lhr-solar/VehicleControlUnit/README.md

# VehicleControlUnit
Vehicle Control Unit (VCU) for the 2027 Longhorn Racing Solar car
