lhr-solar/VehicleControlUnit/Hardware/VehicleControlUnit/3d models/ROE-3.305S.step

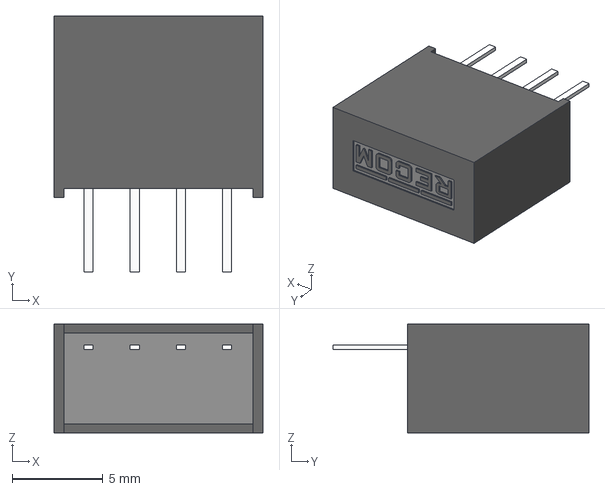
[picture p1: CAD file, 2026-09-12]
Hardware/VehicleControlUnit/3d models/ROE-3.305S.step
11.5 x 14.1 x 6.00 mm
