lhr-solar/VehicleControlUnit/Hardware/VehicleControlUnit/3d models/IRLML2030TRPBF.stp

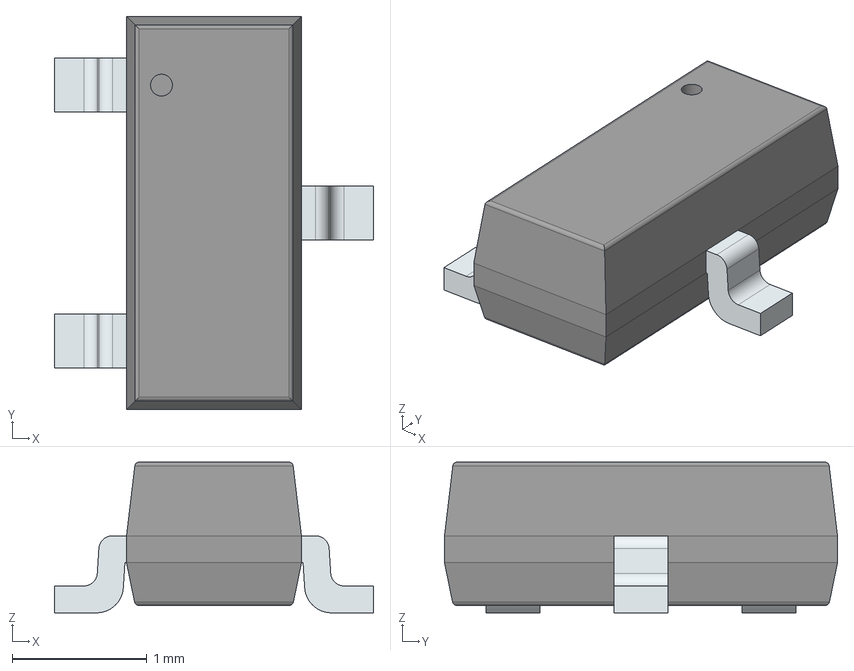
[picture p2: CAD file, 2026-09-12]
Hardware/VehicleControlUnit/3d models/IRLML2030TRPBF.stp
2.37 x 2.92 x 1.12 mm
PinsArrayL
FilletPinR
