lhr-solar/VehicleControlUnit/Hardware/VehicleControlUnit/3d models/VSSAF522-M3_H.stp

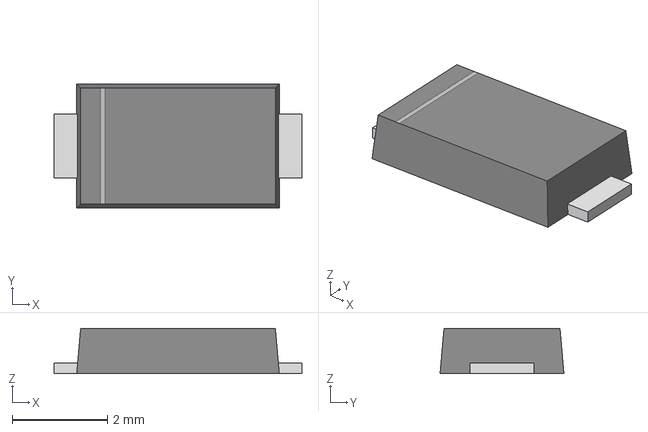
[picture p3: CAD file, 2026-09-12]
Hardware/VehicleControlUnit/3d models/VSSAF522-M3_H.stp
5.20 x 2.60 x 0.951 mm
