lhr-solar/VehicleControlUnit/Hardware/VehicleControlUnit/3d models/EMC2305-1-AP-TR.stp

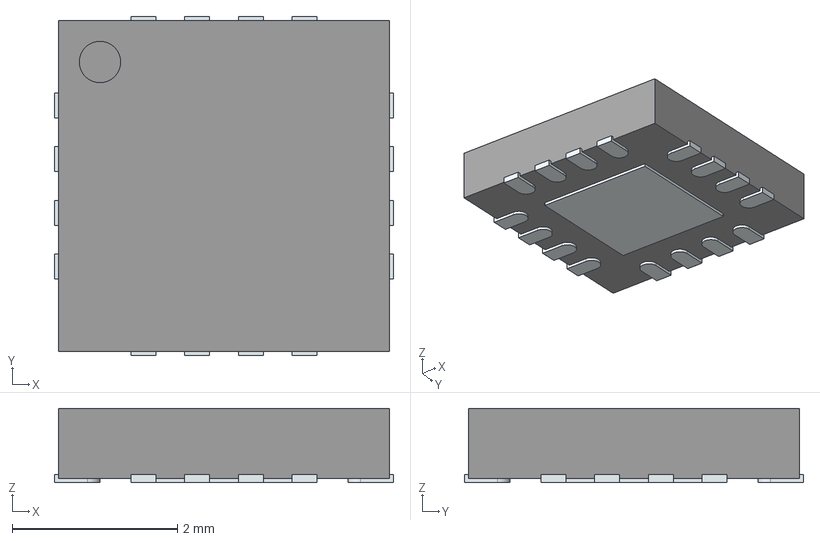
[picture p4: CAD file, 2026-09-07]
Hardware/VehicleControlUnit/3d models/EMC2305-1-AP-TR.stp
4.10 x 4.10 x 0.9 mm
ThermalPin
PinsArrayLR
PinsArrayTB
