lhr-solar/VehicleControlUnit/Hardware/VehicleControlUnit/3d models/MCP4822T-E_SN.stp

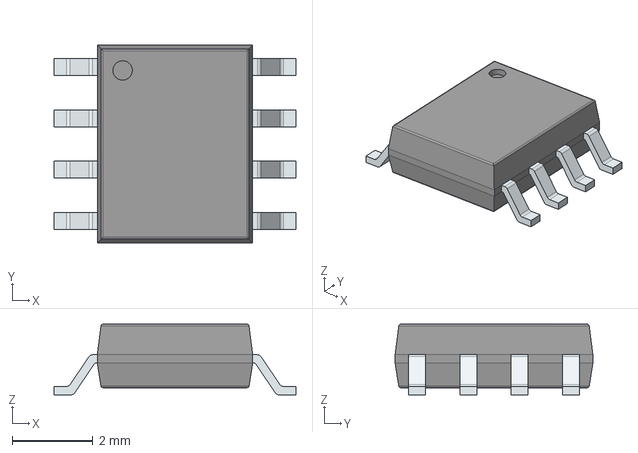
[picture p5: CAD file, 2026-09-07]
Hardware/VehicleControlUnit/3d models/MCP4822T-E_SN.stp
6.00 x 4.90 x 1.75 mm
PinsArrayLR
