lhr-solar/VehicleControlUnit/Hardware/VehicleControlUnit/3d models/ISO7741DWR.stp

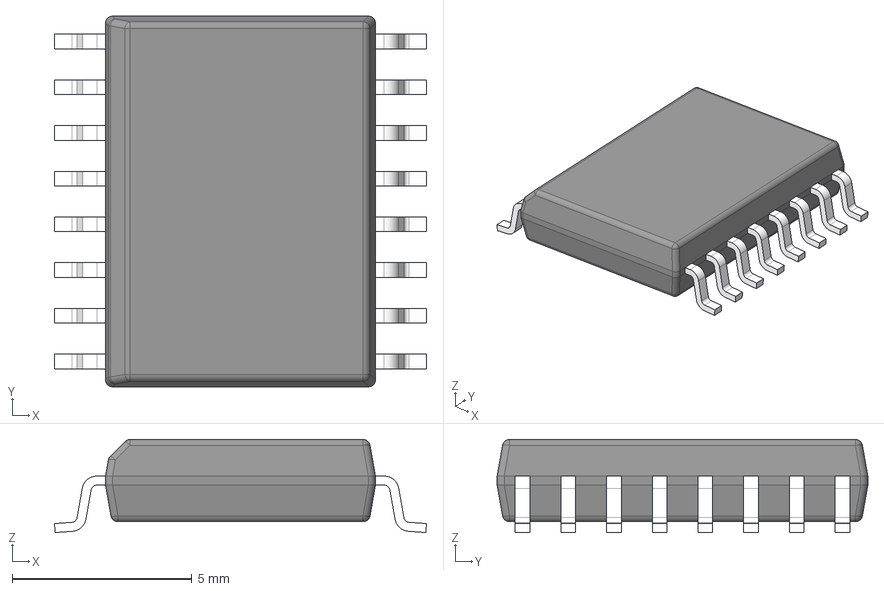
[picture p6: CAD file, 2026-09-07]
Hardware/VehicleControlUnit/3d models/ISO7741DWR.stp
10.3 x 10.3 x 2.59 mm
BODY-SOIC
LEAD-DW0016 x 16
