lhr-solar/VehicleControlUnit/Hardware/VehicleControlUnit/12VBuck.kicad_sch

## KiCad design Hardware/VehicleControlUnit/12VBuck.kicad_sch (2026-09-12)

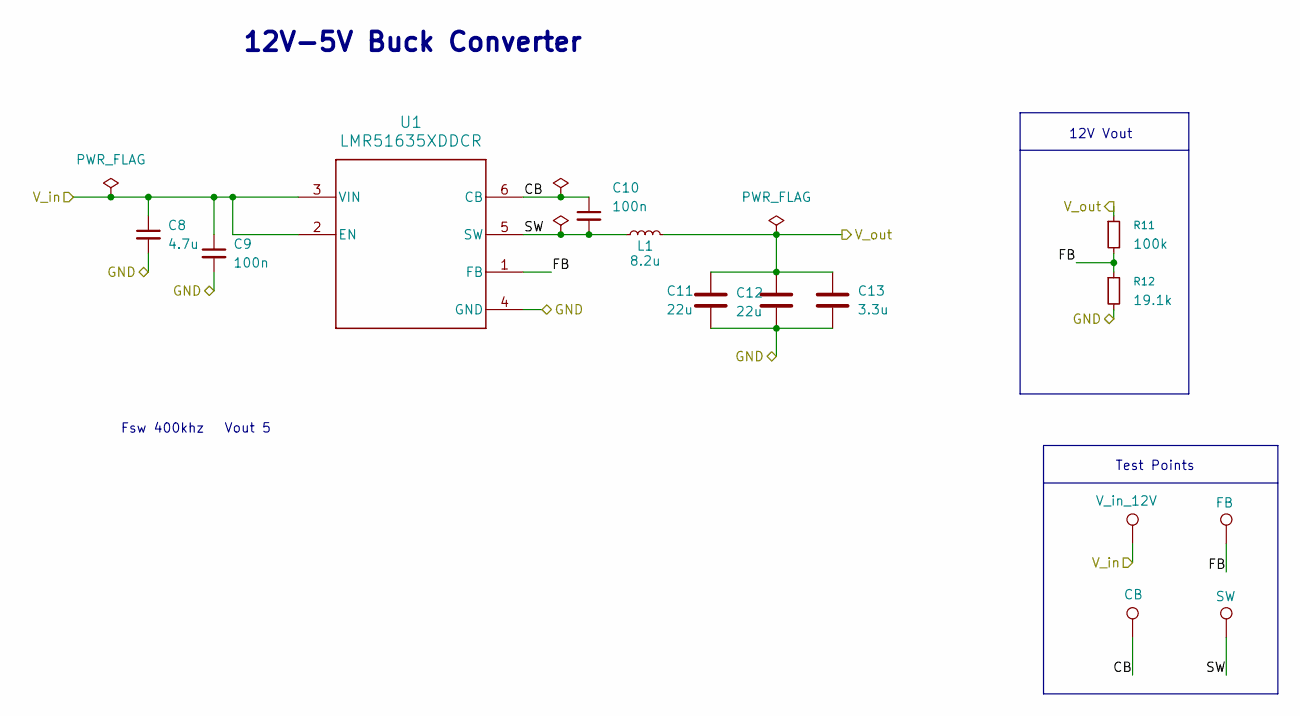
[picture p7: schematic 12VBuck.kicad_sch]

Parts:
C8: 4.7u; C_0805_2012Metric_Pad1.18x1.45mm_HandSolder; LCSC P/N C6962403
C9: 100n; C_0603_1608Metric_Pad1.08x0.95mm_HandSolder; LCSC P/N C6666325
C10: 100n; C_0603_1608Metric; LCSC P/N C6666325
C11, C12: 22u; C_1210_3225Metric_Pad1.33x2.70mm_HandSolder; LCSC P/N C778721
C13: 3.3u; C_0805_2012Metric_Pad1.18x1.45mm_HandSolder; LCSC P/N C342775
L1: 8.2u; 74439369082
R11: 100k; R_0603_1608Metric; LCSC P/N C25803
R12: 19.1k; R_0603_1608Metric; LCSC P/N C844132
TP1: V_in_12V; TestPoint_THTPad_D3.0mm_Drill1.5mm
TP2: CB; TestPoint_THTPad_D3.0mm_Drill1.5mm
TP3: FB; TestPoint_THTPad_D3.0mm_Drill1.5mm
TP4: SW; TestPoint_THTPad_D3.0mm_Drill1.5mm
U1: LMR51635XDDCR; DDC0006A-MFG; LCSC P/N C42432812

Connections:
CB: C10.1, TP2.1, U1.6 (CB)
FB: R11.2, R12.1, TP3.1, U1.1 (FB)
GND: C8.2, C9.2, C11.2, C12.2, C13.2, R12.2, U1.4 (GND)
SW: C10.2, L1.1, TP4.1, U1.5 (SW)
V_in: C8.1, C9.1, TP1.1, U1.2 (EN), U1.3 (VIN)
V_out: C11.1, C12.1, C13.1, L1.2, R11.1

Notes on the sheet:
12V Vout
Test Points
Fsw 400khz
Vout 5
12V-5V Buck Converter
