lhr-solar/VehicleControlUnit/Hardware/VehicleControlUnit/100PinMCU.kicad_sch

## KiCad design Hardware/VehicleControlUnit/100PinMCU.kicad_sch (2026-09-12)

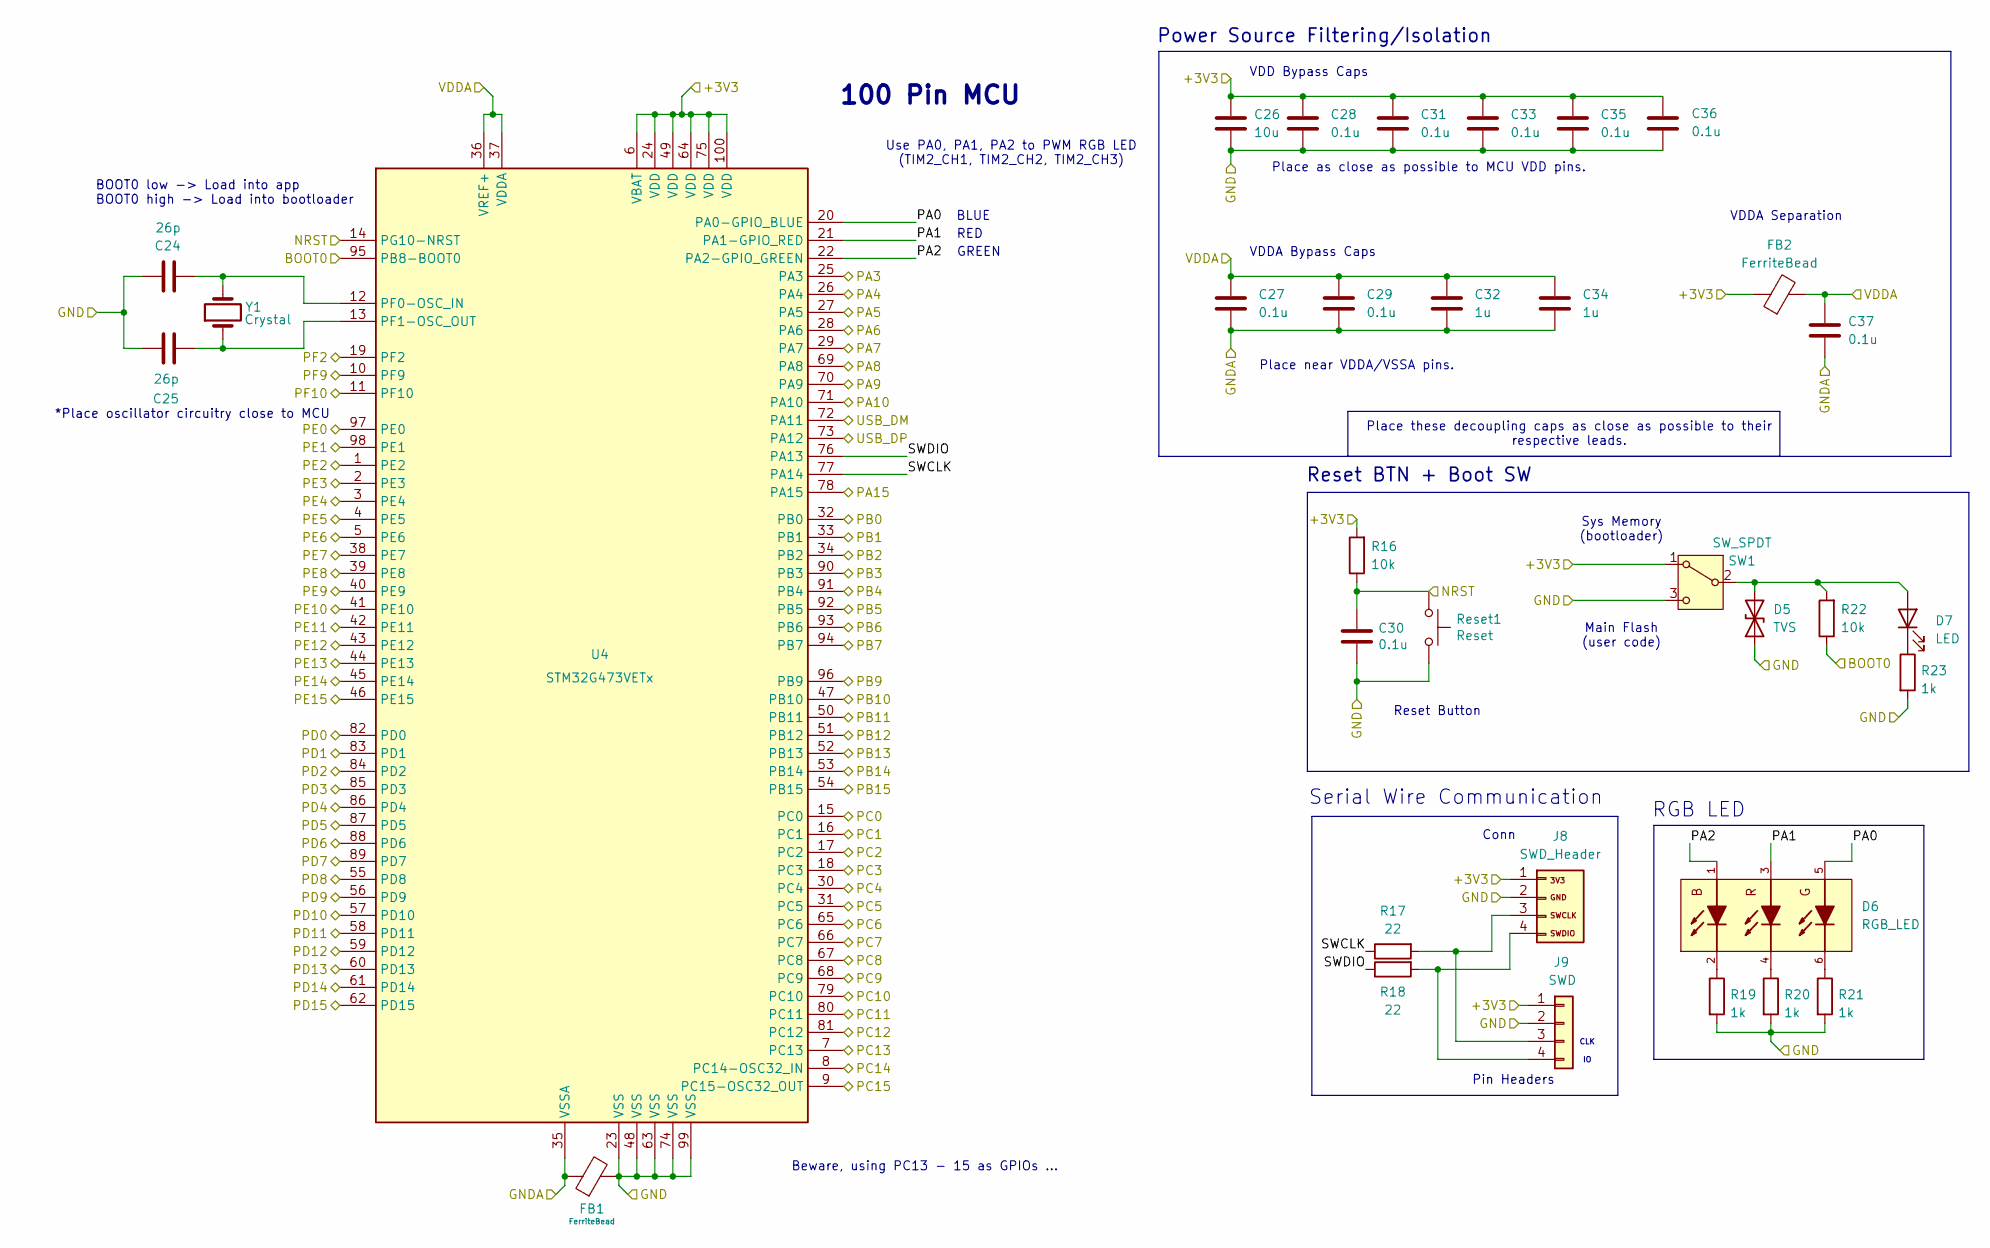
[picture p8: schematic 100PinMCU.kicad_sch]

Parts:
C24, C25: 26p; C_0603_1608Metric_Pad1.08x0.95mm_HandSolder; LCSC P/N C92670
C26: 10u; C_0805_2012Metric; Mouser Part Number 08055D475KAT4A
C27, C28, C29, C30, C31, C33, C35, C36, C37: 0.1u; C_0603_1608Metric_Pad1.08x0.95mm_HandSolder; Mouser Part Number MLASH168SB7104KTNA01
C32, C34: 1u; C_0603_1608Metric_Pad1.08x0.95mm_HandSolder; Mouser Part Number MLASH168SB7104KTNA01
D5: TVS; D_SOD-323; Mouser P/N 771-PESD15VL1BA-T/R
D6: RGB_LED; LCSC P/N C264519
D7: LED; LED_0603_1608Metric; LCSC P/N C125103
FB1, FB2: FerriteBead; C_0603_1608Metric_Pad1.08x0.95mm_HandSolder; LCSC P/N C2649096
J8: SWD_Header; SWD_Conn; LCSC P/N C17492485
J9: SWD; PinHeader_1x04_P2.54mm_Vertical
R16, R22: 10k; R_0603_1608Metric_Pad0.98x0.95mm_HandSolder; Mouser Part Number CRCW060310K0FKEI
R17, R18: 22; R_0603_1608Metric_Pad0.98x0.95mm_HandSolder; LCSC P/N C2930077
R19, R20, R21, R23: 1k; R_0603_1608Metric_Pad0.98x0.95mm_HandSolder; LCSC P/N C21190
Reset1: Reset; TL3365AF180QG; LCSC P/N C2886926
SW1: SW_SPDT; BootSW
U4: STM32G473VETx; 100PinMCU; LCSC P/N C730122
Y1: Crystal; Crystal_SMD_Abracon_ABM3-2Pin_5.0x3.2mm; LCSC P/N C144380

Connections:
+3V3: C26.1, C28.1, C31.1, C33.1, C35.1, C36.1, FB2.1, J8.1, J9.1, R16.2, SW1.1 (A), U4.6 (VBAT), U4.24 (VDD), U4.49 (VDD), U4.64 (VDD), U4.75 (VDD), U4.100 (VDD)
BOOT0: R22.1, U4.95 (PB8-BOOT0)
GND: C24.1, C25.1, C26.2, C28.2, C30.2, C31.2, C33.2, C35.2, C36.2, D5.1 (A1), FB1.2, J8.2, J9.2, R19.2, R20.2, R21.2, R23.2, Reset1.2, SW1.3 (C), U4.23 (VSS), U4.48 (VSS), U4.63 (VSS), U4.74 (VSS), U4.99 (VSS)
GNDA: C27.2, C29.2, C32.2, C34.2, C37.2, FB1.1, U4.35 (VSSA)
NRST: C30.1, R16.1, Reset1.1, U4.14 (PG10-NRST)
unnamed: C24.2, U4.12 (PF0-OSC_IN), Y1.2
unnamed: C25.2, U4.13 (PF1-OSC_OUT), Y1.1
unnamed: D5.2 (A2), D7.2 (A), R22.2, SW1.2 (B)
unnamed: D6.2, R19.1
unnamed: D6.4, R20.1
unnamed: D6.6, R21.1
unnamed: D7.1 (K), R23.1
unnamed: J8.3, J9.3, R17.2
unnamed: J8.4, J9.4, R18.2
PA0: D6.5, U4.20 (PA0-GPIO_BLUE)
PA1: D6.3, U4.21 (PA1-GPIO_RED)
PA2: D6.1, U4.22 (PA2-GPIO_GREEN)
PA3: U4.25 (PA3)
PA4: U4.26 (PA4)
PA5: U4.27 (PA5)
PA6: U4.28 (PA6)
PA7: U4.29 (PA7)
PA8: U4.69 (PA8)
PA9: U4.70 (PA9)
PA10: U4.71 (PA10)
PA15: U4.78 (PA15)
PB0: U4.32 (PB0)
PB1: U4.33 (PB1)
PB2: U4.34 (PB2)
PB3: U4.90 (PB3)
PB4: U4.91 (PB4)
PB5: U4.92 (PB5)
PB6: U4.93 (PB6)
PB7: U4.94 (PB7)
PB9: U4.96 (PB9)
PB10: U4.47 (PB10)
PB11: U4.50 (PB11)
PB12: U4.51 (PB12)
PB13: U4.52 (PB13)
PB14: U4.53 (PB14)
PB15: U4.54 (PB15)
PC0: U4.15 (PC0)
PC1: U4.16 (PC1)
PC2: U4.17 (PC2)
PC3: U4.18 (PC3)
PC4: U4.30 (PC4)
PC5: U4.31 (PC5)
PC6: U4.65 (PC6)
PC7: U4.66 (PC7)
PC8: U4.67 (PC8)
PC9: U4.68 (PC9)
PC10: U4.79 (PC10)
PC11: U4.80 (PC11)
PC12: U4.81 (PC12)
PC13: U4.7 (PC13)
PC14: U4.8 (PC14-OSC32_IN)
PC15: U4.9 (PC15-OSC32_OUT)
PD0: U4.82 (PD0)
PD1: U4.83 (PD1)
PD2: U4.84 (PD2)
PD3: U4.85 (PD3)
PD4: U4.86 (PD4)
PD5: U4.87 (PD5)
PD6: U4.88 (PD6)
PD7: U4.89 (PD7)
PD8: U4.55 (PD8)
PD9: U4.56 (PD9)
PD10: U4.57 (PD10)
PD11: U4.58 (PD11)
PD12: U4.59 (PD12)
PD13: U4.60 (PD13)
PD14: U4.61 (PD14)
PD15: U4.62 (PD15)
PE0: U4.97 (PE0)
PE1: U4.98 (PE1)
PE2: U4.1 (PE2)
PE3: U4.2 (PE3)
PE4: U4.3 (PE4)
PE5: U4.4 (PE5)
PE6: U4.5 (PE6)
PE7: U4.38 (PE7)
PE8: U4.39 (PE8)
PE9: U4.40 (PE9)
PE10: U4.41 (PE10)
PE11: U4.42 (PE11)
PE12: U4.43 (PE12)
PE13: U4.44 (PE13)
PE14: U4.45 (PE14)
PE15: U4.46 (PE15)
PF2: U4.19 (PF2)
PF9: U4.10 (PF9)
PF10: U4.11 (PF10)
SWCLK: R17.1, U4.77 (PA14)
SWDIO: R18.1, U4.76 (PA13)
USB_DM: U4.72 (PA11)
USB_DP: U4.73 (PA12)
VDDA: C27.1, C29.1, C32.1, C34.1, C37.1, FB2.2, U4.36 (VREF+), U4.37 (VDDA)

Notes on the sheet:
BLUE
Power Source Filtering/Isolation
Sys Memory (bootloader)
RED
Main Flash (user code)
VDDA Separation
Beware, using PC13 - 15 as GPIOs ...
GREEN
VDD Bypass Caps
Conn
Reset Button
CLK
RGB LED
BOOT0 low -> Load into app BOOT0 high -> Load into bootloader
VDDA Bypass Caps
Serial Wire Communication
Place these decoupling caps as close as possible to their respective leads.
100 Pin MCU
Use PA0, PA1, PA2 to PWM RGB LED (TIM2_CH1, TIM2_CH2, TIM2_CH3)
Reset BTN + Boot SW
Place as close as possible to MCU VDD pins.
Place near VDDA/VSSA pins.
Pin Headers
*Place oscillator circuitry close to MCU
