lhr-solar/VehicleControlUnit/Hardware/VehicleControlUnit/CarCAN.kicad_sch

## KiCad design Hardware/VehicleControlUnit/CarCAN.kicad_sch (2026-09-12)

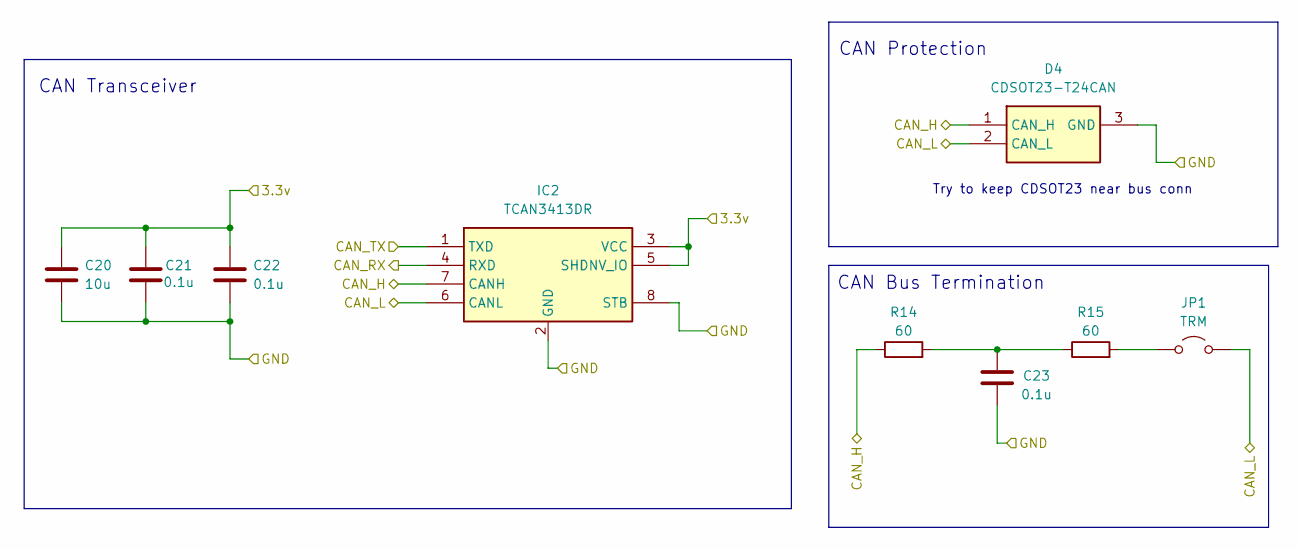
[picture p9: schematic CarCAN.kicad_sch]

Parts:
C20: 10u; C_0805_2012Metric_Pad1.18x1.45mm_HandSolder; LCSC P/N C440198
C21, C22, C23: 0.1u; C_0603_1608Metric_Pad1.08x0.95mm_HandSolder; LCSC P/N C14663
D4: CDSOT23-T24CAN; Mouser Part Number 652-CDSOT23-T24CAN
IC2: TCAN3413DR; Mouser Part Number 595-TCAN3413DR
JP1: TRM; PinHeader_1x02_P2.54mm_Vertical
R14, R15: 60; R_0603_1608Metric_Pad0.98x0.95mm_HandSolder; LCSC P/N C166918

Connections:
3.3v: C20.1, C21.1, C22.1, IC2.3 (VCC), IC2.5 (SHDNV_IO)
CAN_H: D4.1 (CAN_H), IC2.7 (CANH), R14.1
CAN_L: D4.2 (CAN_L), IC2.6 (CANL), JP1.2 (B)
CAN_RX: IC2.4 (RXD)
CAN_TX: IC2.1 (TXD)
GND: C20.2, C21.2, C22.2, C23.1, D4.3 (GND), IC2.2 (GND), IC2.8 (STB)
unnamed: C23.2, R14.2, R15.1
unnamed: JP1.1 (A), R15.2

Notes on the sheet:
CAN Transceiver
Try to keep CDSOT23 near bus conn
CAN Protection
CAN Bus Termination
