lhr-solar/VehicleControlUnit/Hardware/VehicleControlUnit/LDO.kicad_sch

## KiCad design Hardware/VehicleControlUnit/LDO.kicad_sch (2026-09-12)

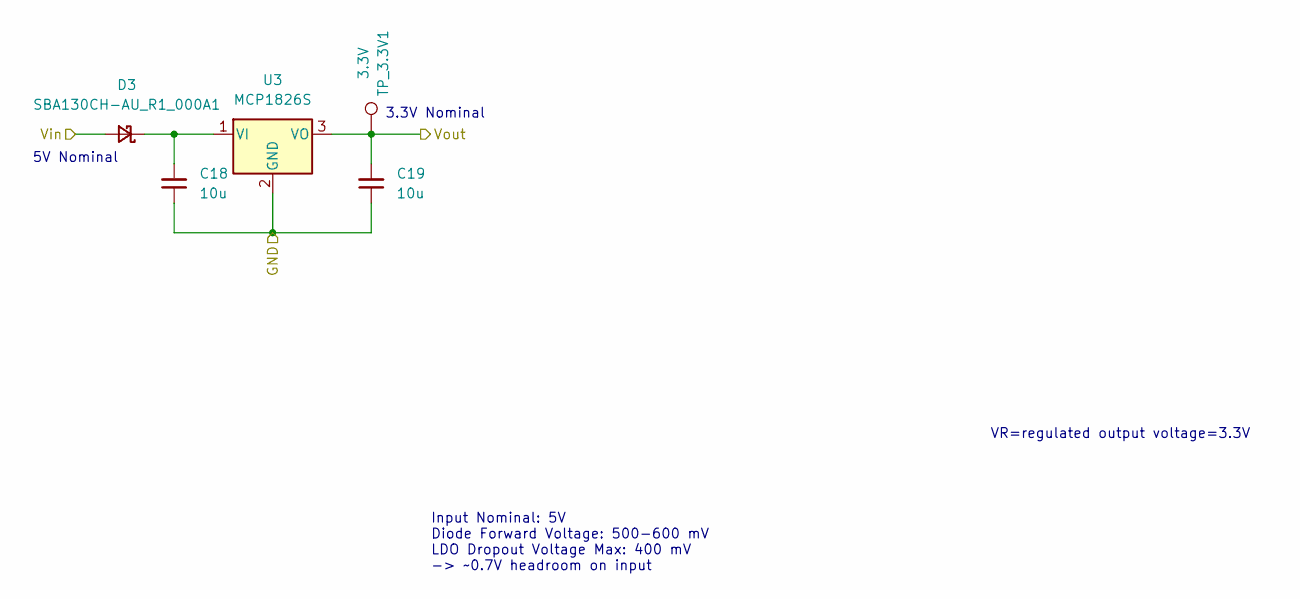
[picture p10: schematic LDO.kicad_sch]

Parts:
C18, C19: 10u; C_0805_2012Metric_Pad1.18x1.45mm_HandSolder; Mouser P/N GRM21BR61H106KE43K
D3: SBA130CH-AU_R1_000A1; D_SOD-323_HandSoldering; LCSC P/N C191023
TP_3.3V1: 3.3V; TestPoint_Loop_D1.80mm_Drill1.0mm_Beaded
U3: MCP1826S; SOT-223-3_TabPin2; LCSC P/N C126055

Connections:
GND: C18.1, C19.1, U3.2 (GND)
unnamed: C18.2, D3.1 (K), U3.1 (VI)
Vin: D3.2 (A)
Vout: C19.2, TP_3.3V1.1, U3.3 (VO)

Notes on the sheet:
5V Nominal
Input Nominal: 5V Diode Forward Voltage: 500-600 mV LDO Dropout Voltage Max: 400 mV -> ~0.7V headroom on input
VR=regulated output voltage=3.3V
3.3V Nominal
