lhr-solar/VehicleControlUnit/Hardware/VehicleControlUnit/MUC_Peripherals.kicad_sch

## KiCad design Hardware/VehicleControlUnit/MUC_Peripherals.kicad_sch (2026-09-12)

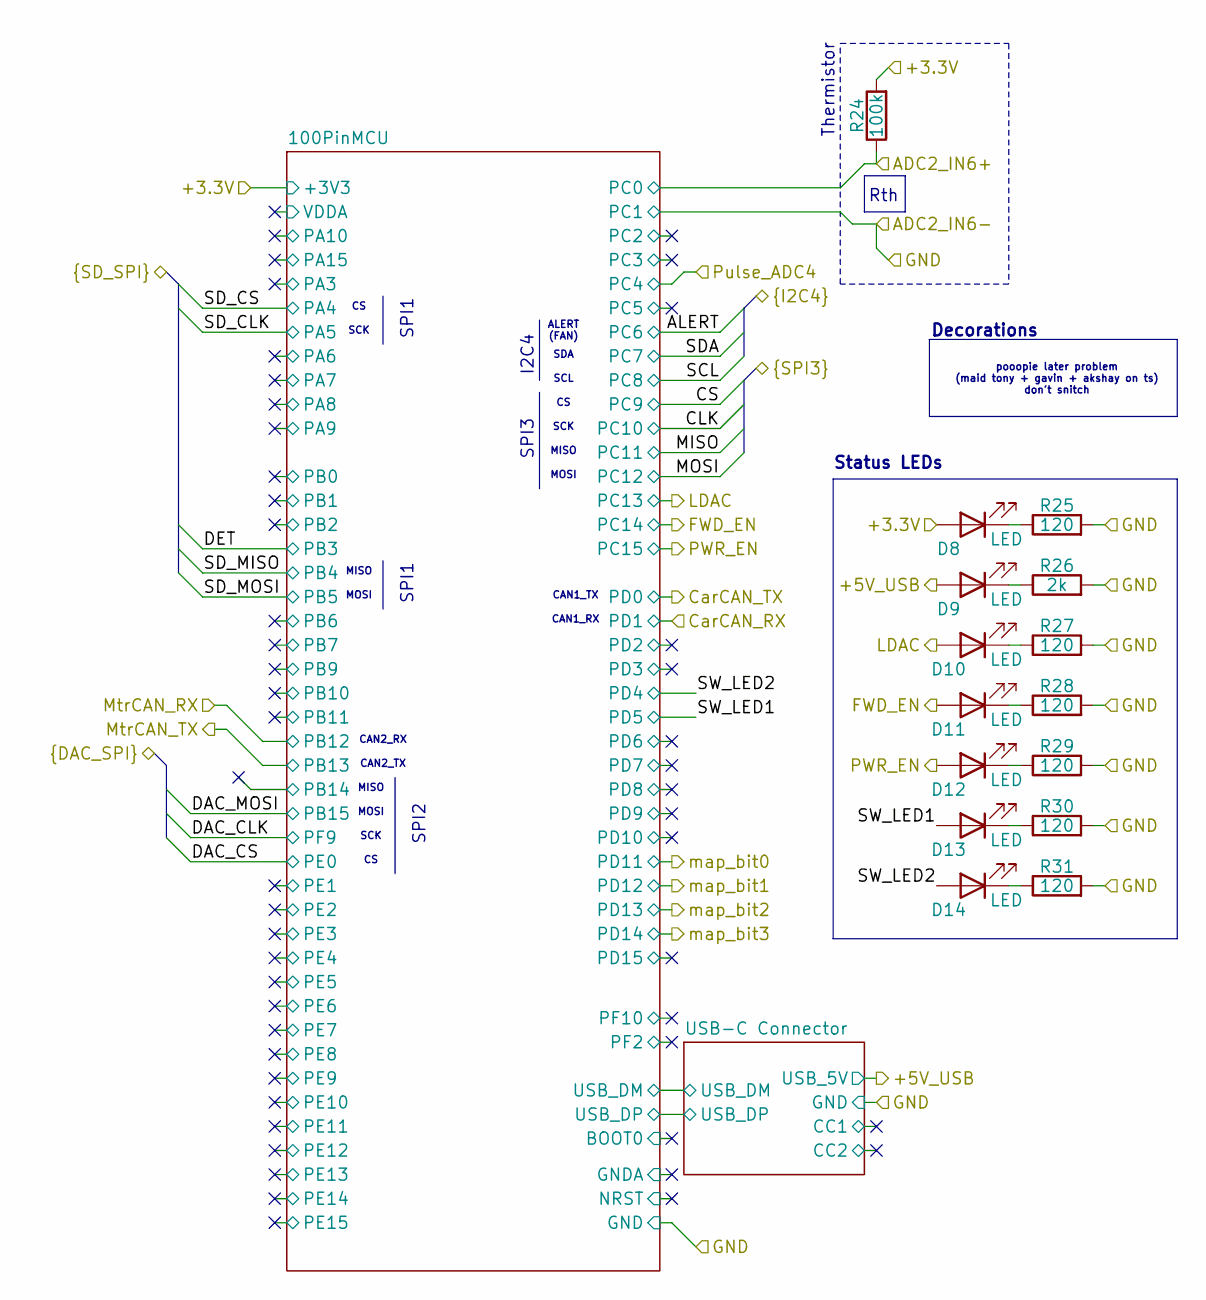
[picture p11: schematic MUC_Peripherals.kicad_sch]

Parts:
D8, D9, D10, D11, D12, D13, D14: LED; LED_0603_1608Metric
R24: 100k; R_0603_1608Metric_Pad0.98x0.95mm_HandSolder
R25, R27, R28, R29, R30, R31: 120; R_0603_1608Metric_Pad0.98x0.95mm_HandSolder
R26: 2k; R_0603_1608Metric_Pad0.98x0.95mm_HandSolder

Connections:
+3.3V: D8.2 (A), R24.2
+5V_USB: D9.2 (A)
ADC2_IN6+: R24.1
ADC2_IN6-: R25.2, R26.2, R27.2, R28.2, R29.2, R30.2, R31.2
FWD_EN: D11.2 (A)
LDAC: D10.2 (A)
unnamed: D8.1 (K), R25.1
unnamed: D9.1 (K), R26.1
unnamed: D10.1 (K), R27.1
unnamed: D11.1 (K), R28.1
unnamed: D12.1 (K), R29.1
unnamed: D13.1 (K), R30.1
unnamed: D14.1 (K), R31.1
PWR_EN: D12.2 (A)
SW_LED1: D13.2 (A)
SW_LED2: D14.2 (A)

Notes on the sheet:
SPI1
CAN2_RX
pooopie later problem (maid tony + gavin + akshay on ts) don't snitch
Status LEDs
Rth
CAN1_RX
MISO
SDA
MOSI
SPI2
SCK
SPI3
CAN2_TX
Thermistor
ALERT (FAN)
SCL
I2C4
CAN1_TX
Decorations
