lhr-solar/VehicleControlUnit/Hardware/VehicleControlUnit/Motor_Comms.kicad_sch

## KiCad design Hardware/VehicleControlUnit/Motor_Comms.kicad_sch (2026-09-12)

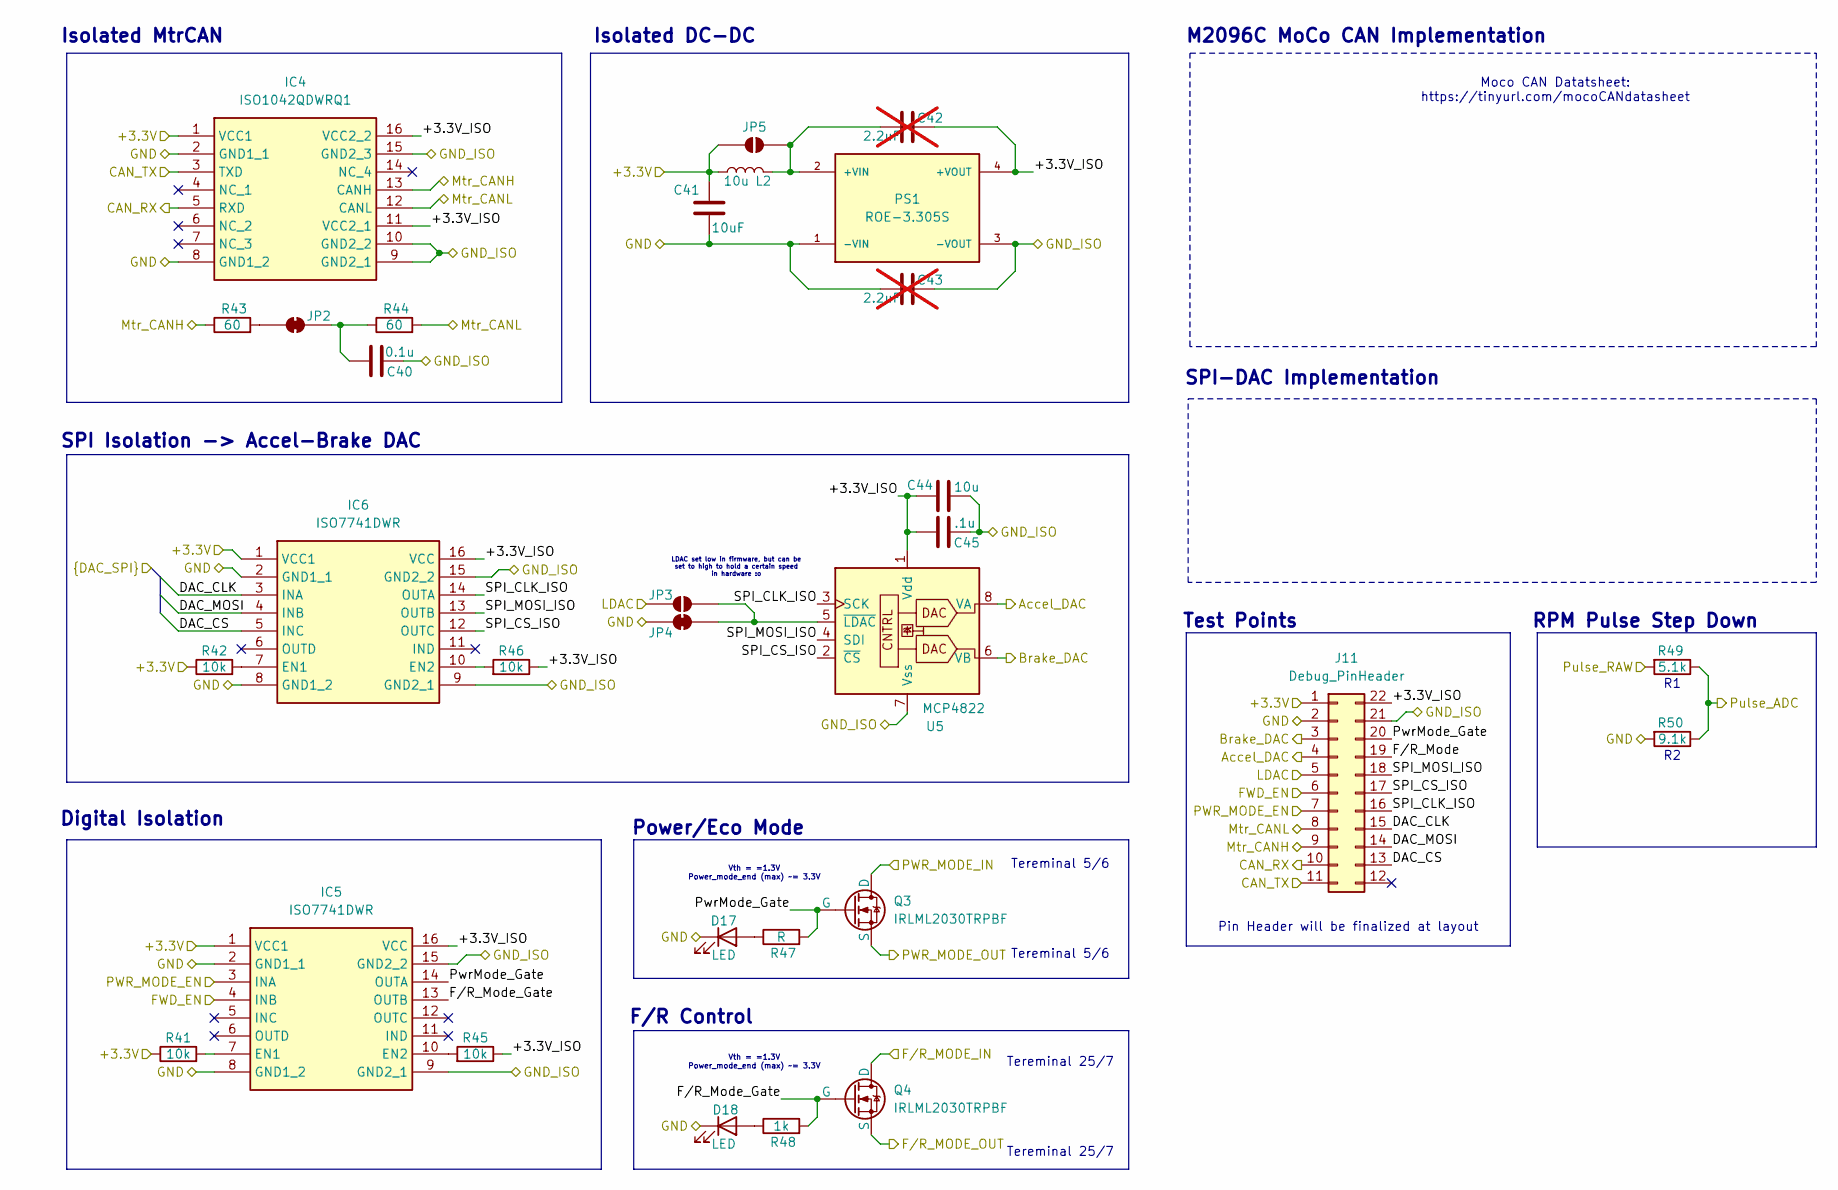
[picture p12: schematic Motor_Comms.kicad_sch]

Parts:
C40: 0.1u; C_0603_1608Metric_Pad1.08x0.95mm_HandSolder
C41: 10uF; C_0603_1608Metric_Pad1.08x0.95mm_HandSolder
C42, C43: 2.2uF; C_0603_1608Metric_Pad1.08x0.95mm_HandSolder; not fitted
C44: 10u; C_0603_1608Metric_Pad1.08x0.95mm_HandSolder
C45: .1u; C_0603_1608Metric_Pad1.08x0.95mm_HandSolder
D17, D18: LED; LED_0603_1608Metric
IC4: ISO1042QDWRQ1; Mouser Part Number 595-ISO1042QDWRQ1
IC5, IC6: ISO7741DWR; Mouser Part Number 595-ISO7741DWR
J11: Debug_PinHeader; PinHeader_2x11_P1.00mm_Vertical
JP2, JP4: SolderJumper_2_Bridged; SolderJumper-2_P1.3mm_Bridged2Bar_RoundedPad1.0x1.5mm
JP3, JP5: SolderJumper_2_Open; SolderJumper-2_P1.3mm_Open_RoundedPad1.0x1.5mm
L2: 10u; WE-MAIA_2512
PS1: ROE-3.305S; CONV_ROE-3.305S; PARTREV 5
Q3, Q4: IRLML2030TRPBF
R41, R42, R45, R46: 10k; R_0603_1608Metric_Pad0.98x0.95mm_HandSolder
R43, R44: 60; R_0603_1608Metric_Pad0.98x0.95mm_HandSolder
R47: R; R_0603_1608Metric_Pad0.98x0.95mm_HandSolder
R48: 1k; R_0603_1608Metric_Pad0.98x0.95mm_HandSolder
R49: 5.1k; R_0603_1608Metric_Pad0.98x0.95mm_HandSolder
R50: 9.1k; R_0603_1608Metric_Pad0.98x0.95mm_HandSolder
U5: MCP4822; MCP4822T-E_SN

Connections:
+3.3V: C41.1, IC4.1 (VCC1), IC5.1 (VCC1), IC6.1 (VCC1), J11.1, JP5.1 (A), L2.2, R41.1, R42.1
+3.3V_ISO: C42.1, C44.2, C45.2, IC4.11 (VCC2_1), IC4.16 (VCC2_2), IC5.16 (VCC), IC6.16 (VCC), J11.22, PS1.4 (+VOUT), R45.1, R46.1, U5.1 (Vdd)
Accel_DAC: J11.4, U5.8 (VA)
Brake_DAC: J11.3, U5.6 (VB)
CAN_RX: IC4.5 (RXD), J11.10
CAN_TX: IC4.3 (TXD), J11.11
DAC_CLK: IC6.3 (INA), J11.15
DAC_CS: IC6.5 (INC), J11.13
DAC_MOSI: IC6.4 (INB), J11.14
FWD_EN: IC5.4 (INB), J11.6
F/R_MODE_IN: Q4.1 (D)
F/R_MODE_OUT: Q4.3 (S)
F/R_Mode: J11.19
F/R_Mode_Gate: IC5.13 (OUTB), Q4.2 (G), R48.2
GND: C41.2, C43.2, D17.1 (K), D18.1 (K), IC4.2 (GND1_1), IC4.8 (GND1_2), IC5.2 (GND1_1), IC5.8 (GND1_2), IC6.2 (GND1_1), IC6.8 (GND1_2), J11.2, JP4.1 (A), PS1.1 (-VIN), R50.2
GND_ISO: C40.2, C43.1, C44.1, C45.1, IC4.9 (GND2_1), IC4.10 (GND2_2), IC4.15 (GND2_3), IC5.9 (GND2_1), IC5.15 (GND2_2), IC6.9 (GND2_1), IC6.15 (GND2_2), J11.21, PS1.3 (-VOUT), U5.7 (Vss)
LDAC: J11.5, JP3.1 (A)
Mtr_CANH: IC4.13 (CANH), J11.9, R43.1
Mtr_CANL: IC4.12 (CANL), J11.8, R44.2
unnamed: C40.1, JP2.2 (B), R44.1
unnamed: C42.2, JP5.2 (B), L2.1, PS1.2 (+VIN)
unnamed: D17.2 (A), R47.1
unnamed: D18.2 (A), R48.1
unnamed: IC5.7 (EN1), R41.2
unnamed: IC5.10 (EN2), R45.2
unnamed: IC6.7 (EN1), R42.2
unnamed: IC6.10 (EN2), R46.2
unnamed: JP2.1 (A), R43.2
unnamed: JP3.2 (B), JP4.2 (B), U5.5 (~LDAC)
PWR_MODE_EN: IC5.3 (INA), J11.7
PWR_MODE_IN: Q3.1 (D)
PWR_MODE_OUT: Q3.3 (S)
Pulse_ADC: R49.1, R50.1
Pulse_RAW: R49.2
PwrMode_Gate: IC5.14 (OUTA), J11.20, Q3.2 (G), R47.2
SPI_CLK_ISO: IC6.14 (OUTA), J11.16, U5.3 (SCK)
SPI_CS_ISO: IC6.12 (OUTC), J11.17, U5.2 (~CS)
SPI_MOSI_ISO: IC6.13 (OUTB), J11.18, U5.4 (SDI)

Notes on the sheet:
M2096C MoCo CAN Implementation
Tereminal 25/7
LDAC set low in firmware, but can be set to high to hold a certain speed in hardware :o
RPM Pulse Step Down
SPI-DAC Implementation
Vth = =1.3V Power_mode_end (max) ~= 3.3V
F/R Control
Power/Eco Mode
Isolated MtrCAN
Tereminal 5/6
Isolated DC-DC
Digital Isolation
Moco CAN Datatsheet: https://tinyurl.com/mocoCANdatasheet
Test Points
SPI Isolation -> Accel-Brake DAC
Pin Header will be finalized at layout
