lhr-solar/VehicleControlUnit/Hardware/VehicleControlUnit/PowerProtection.kicad_sch

## KiCad design Hardware/VehicleControlUnit/PowerProtection.kicad_sch (2026-09-12)

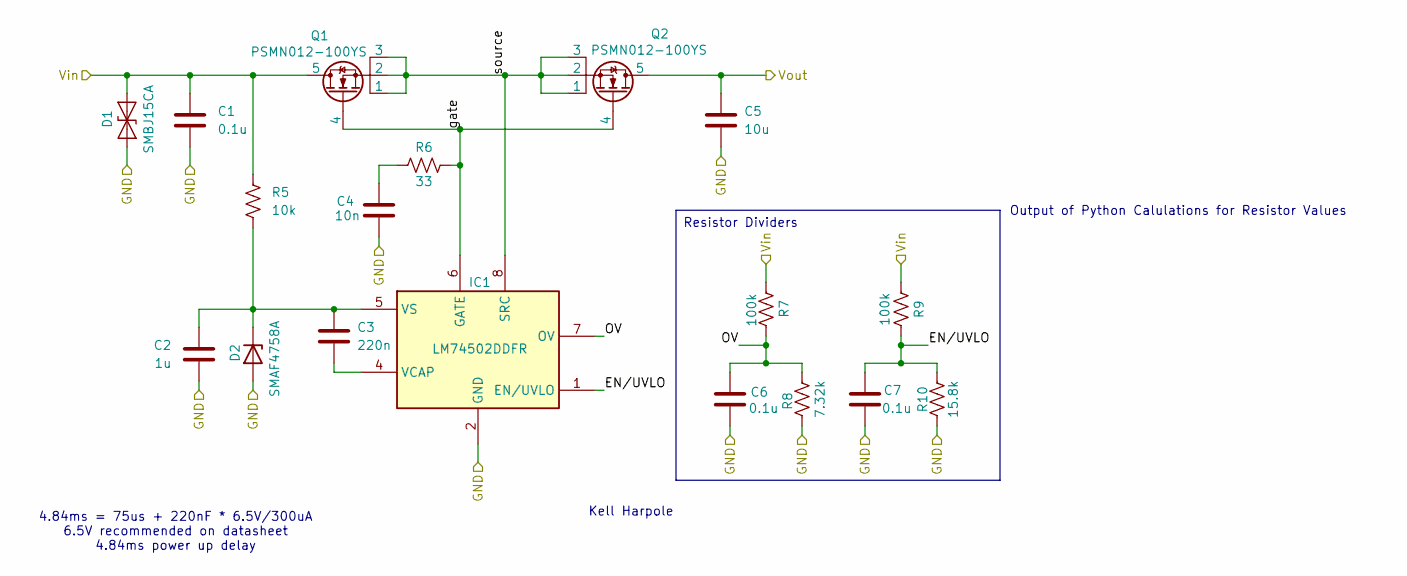
[picture p13: schematic PowerProtection.kicad_sch]

Parts:
C1, C6, C7: 0.1u; C_0603_1608Metric_Pad1.08x0.95mm_HandSolder; LCSC P/N C1591
C2: 1u; C_0603_1608Metric_Pad1.08x0.95mm_HandSolder; LCSC P/N C559769
C3: 220n; C_0603_1608Metric_Pad1.08x0.95mm_HandSolder; LCSC P/N C107083
C4: 10n; C_0603_1608Metric_Pad1.08x0.95mm_HandSolder; LCSC P/N C100042
C5: 10u; C_0805_2012Metric_Pad1.18x1.45mm_HandSolder; LCSC P/N C440198
D1: SMBJ15CA; D_SMB; LCSC P/N C669039
D2: SMAF4758A; SODFL5026X125N; LCSC P/N C183490
IC1: LM74502DDFR; Mouser Part Number 595-LM74502DDFR
Q1, Q2: PSMN012-100YS; LFPAK56; LCSC P/N C20443035
R5: 10k; R_0603_1608Metric_Pad0.98x0.95mm_HandSolder; LCSC P/N C25804
R6: 33; R_0603_1608Metric_Pad0.98x0.95mm_HandSolder; Mouser Part Number 594-MCT06030C3309FP5
R7, R9: 100k; R_0603_1608Metric_Pad0.98x0.95mm_HandSolder; LCSC P/N C25803
R8: 7.32k; R_0603_1608Metric_Pad0.98x0.95mm_HandSolder; LCSC P/N C862286
R10: 15.8k; R_0603_1608Metric_Pad0.98x0.95mm_HandSolder; LCSC P/N C843918

Connections:
EN/UVLO: C7.1, IC1.1 (EN/UVLO), R9.2, R10.2
GND: C1.2, C2.1, C4.2, C5.2, C6.2, C7.2, D1.1 (A1), D2.2 (A), IC1.2 (GND), R8.2, R10.1
unnamed: C2.2, C3.1, D2.1 (K), IC1.5 (VS), R5.1
unnamed: C3.2, IC1.4 (VCAP)
unnamed: C4.1, R6.1
OV: C6.1, IC1.7 (OV), R7.2, R8.1
Vin: C1.1, D1.2 (A2), Q1.5, R5.2, R7.1, R9.1
Vout: C5.1, Q2.5
gate: IC1.6 (GATE), Q1.4, Q2.4, R6.2
source: IC1.8 (SRC), Q1.1, Q1.2, Q1.3, Q2.1, Q2.2, Q2.3

Notes on the sheet:
4.84ms = 75us + 220nF * 6.5V/300uA 6.5V recommended on datasheet 4.84ms power up delay
Output of Python Calulations for Resistor Values
Kell Harpole
Resistor Dividers
