lhr-solar/VehicleControlUnit/Hardware/VehicleControlUnit/Power_Regulation.kicad_sch

## KiCad design Hardware/VehicleControlUnit/Power_Regulation.kicad_sch (2026-09-12)

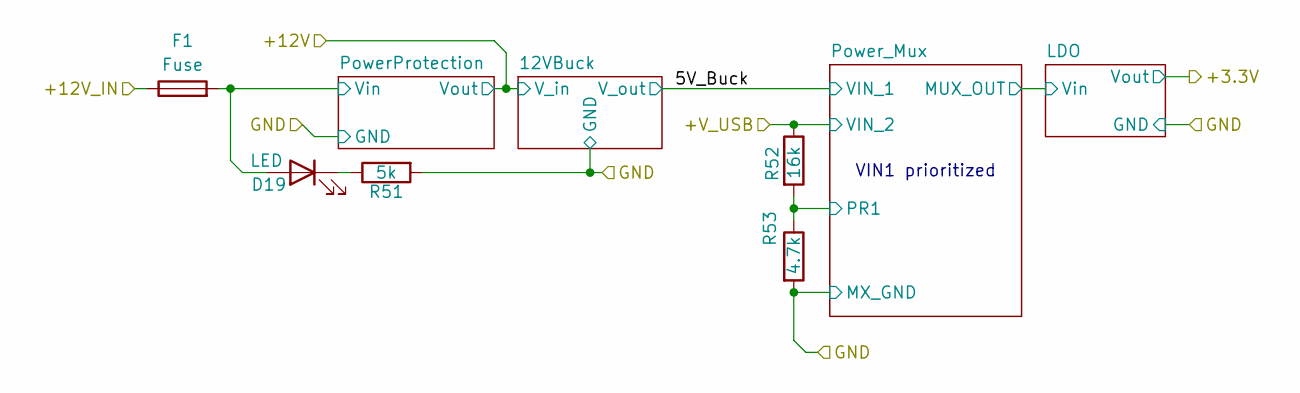
[picture p15: schematic Power_Regulation.kicad_sch]

Parts:
D19: LED; LED_0603_1608Metric
F1: Fuse; FUSE_3568
R51: 5k; R_0603_1608Metric_Pad0.98x0.95mm_HandSolder
R52: 16k; R_0603_1608Metric_Pad0.98x0.95mm_HandSolder
R53: 4.7k; R_0603_1608Metric_Pad0.98x0.95mm_HandSolder

Connections:
+12V_IN: F1.1
+V_USB: R52.1
GND: R51.2, R53.2
unnamed: D19.1 (K), R51.1
PR1: R52.2, R53.1
Vin: D19.2 (A), F1.2

Notes on the sheet:
VIN1 prioritized
