lhr-solar/VehicleControlUnit/Hardware/VehicleControlUnit/SD_Card.kicad_sch

## KiCad design Hardware/VehicleControlUnit/SD_Card.kicad_sch (2026-09-12)

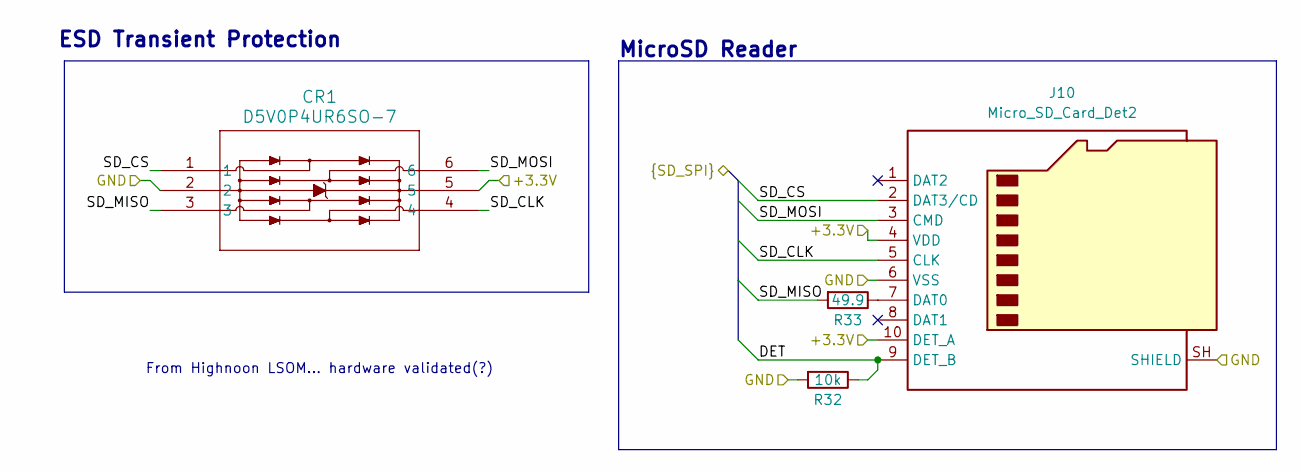
[picture p16: schematic SD_Card.kicad_sch]

Parts:
CR1: D5V0P4UR6SO-7
J10: Micro_SD_Card_Det2; microSD_HC_Hirose_DM3AT-SF-PEJM5
R32: 10k; R_0603_1608Metric_Pad0.98x0.95mm_HandSolder
R33: 49.9; R_0603_1608Metric_Pad0.98x0.95mm_HandSolder

Connections:
+3.3V: CR1.5, J10.4 (VDD), J10.10 (DET_A)
DET: J10.9 (DET_B), R32.1
GND: CR1.2, J10.6 (VSS), J10.SH (SHIELD), R32.2
unnamed: J10.7 (DAT0), R33.1
SD_CLK: CR1.4, J10.5 (CLK)
SD_CS: CR1.1, J10.2 (DAT3/CD)
SD_MISO: CR1.3, R33.2
SD_MOSI: CR1.6, J10.3 (CMD)

Notes on the sheet:
ESD Transient Protection
MicroSD Reader
From Highnoon LSOM... hardware validated(?)
