lhr-solar/VehicleControlUnit/Hardware/VehicleControlUnit/USB-C Connector.kicad_sch

## KiCad design Hardware/VehicleControlUnit/USB-C Connector.kicad_sch (2026-09-12)

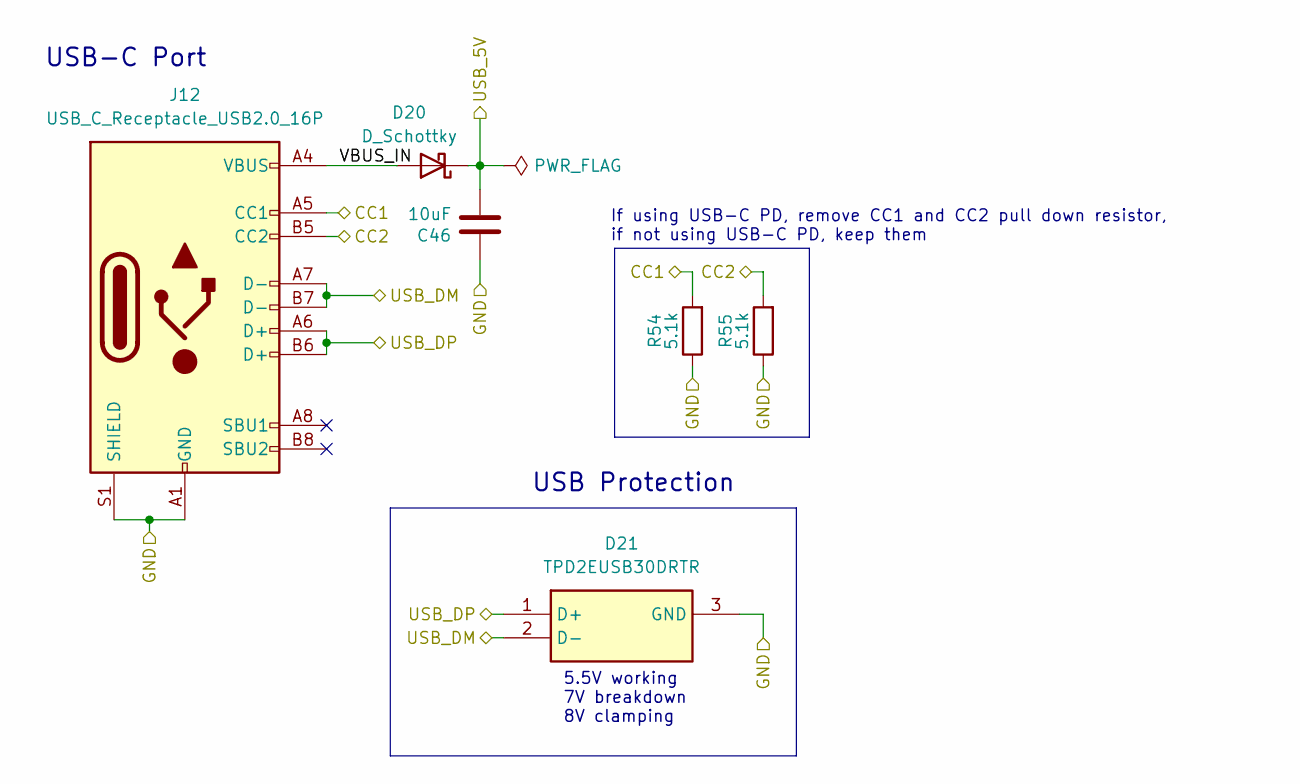
[picture p17: schematic USB-C Connector.kicad_sch]

Parts:
C46: 10uF; C_0805_2012Metric; LCSC P/N C440198
D20: D_Schottky; D_SOD-123; LCSC P/N C82544
D21: TPD2EUSB30DRTR; LCSC P/N C97502
J12: USB_C_Receptacle_USB2.0_16P; USB_C_Receptacle_GCT_USB4105-xx-A_16P_TopMnt_Horizontal
R54, R55: 5.1k; R_0603_1608Metric_Pad0.98x0.95mm_HandSolder; LCSC P/N C23186

Connections:
CC1: J12.A5 (CC1), R54.2
CC2: J12.B5 (CC2), R55.2
GND: C46.1, D21.3 (GND), J12.A1 (GND), J12.A12 (GND), J12.B1 (GND), J12.B12 (GND), J12.S1 (SHIELD), J12.S2 (Shield), J12.S3 (Shield), J12.S4 (Shield), R54.1, R55.1
USB_5V: C46.2, D20.1 (K)
USB_DM: D21.2 (D-), J12.A7 (D-), J12.B7 (D-)
USB_DP: D21.1 (D+), J12.A6 (D+), J12.B6 (D+)
VBUS_IN: D20.2 (A), J12.A4 (VBUS), J12.A9 (VBUS), J12.B4 (VBUS), J12.B9 (VBUS)

Notes on the sheet:
USB Protection
If using USB-C PD, remove CC1 and CC2 pull down resistor, if not using USB-C PD, keep them
5.5V working 7V breakdown 8V clamping
USB-C Port
