lhr-solar/VehicleControlUnit/Hardware/VehicleControlUnit/motor_fans.kicad_sch

## KiCad design Hardware/VehicleControlUnit/motor_fans.kicad_sch (2026-09-12)

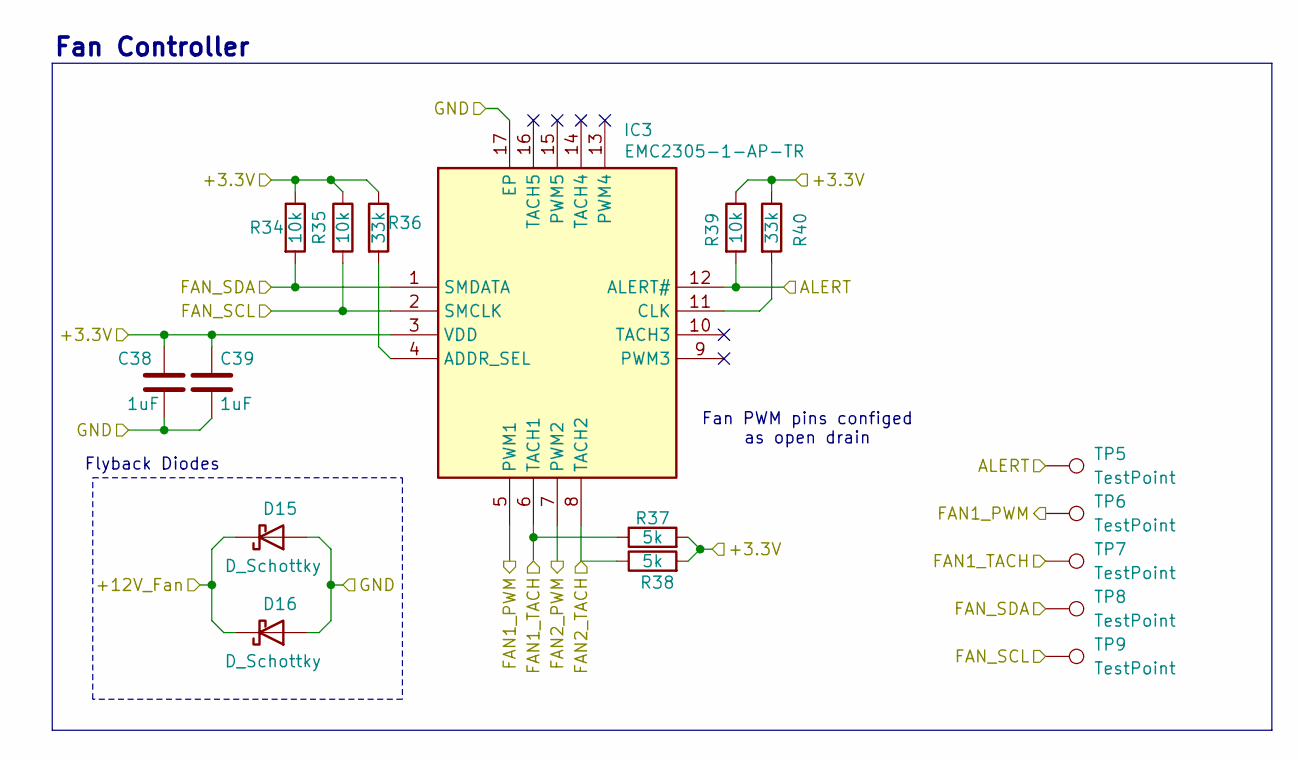
[picture p18: schematic motor_fans.kicad_sch]

Parts:
C38, C39: 1uF; C_0603_1608Metric_Pad1.08x0.95mm_HandSolder
D15, D16: D_Schottky; SODFL5226X100N
IC3: EMC2305-1-AP-TR; Mouser Part Number 886-EMC2305-1-AP-TR
R34, R35, R39: 10k; R_0603_1608Metric_Pad0.98x0.95mm_HandSolder
R36, R40: 33k; R_0603_1608Metric_Pad0.98x0.95mm_HandSolder
R37, R38: 5k; R_0603_1608Metric_Pad0.98x0.95mm_HandSolder
TP5, TP6, TP7, TP8, TP9: TestPoint; TestPoint_HEX_3mmID

Connections:
+3.3V: C38.1, C39.1, IC3.3 (VDD), R34.1, R35.1, R36.1, R37.2, R38.2, R39.1, R40.1
+12V_Fan: D15.1 (K), D16.1 (K)
ALERT: IC3.12 (ALERT#), R39.2, TP5.1
FAN1_PWM: IC3.5 (PWM1), TP6.1
FAN1_TACH: IC3.6 (TACH1), R37.1, TP7.1
FAN2_PWM: IC3.7 (PWM2)
FAN2_TACH: IC3.8 (TACH2), R38.1
FAN_SCL: IC3.2 (SMCLK), R35.2, TP9.1
FAN_SDA: IC3.1 (SMDATA), R34.2, TP8.1
GND: C38.2, C39.2, D15.2 (A), D16.2 (A), IC3.17 (EP)
unnamed: IC3.4 (ADDR_SEL), R36.2
unnamed: IC3.11 (CLK), R40.2

Notes on the sheet:
Fan Controller
Fan PWM pins configed as open drain
Flyback Diodes
