lhr-solar/VehicleControlUnit/Hardware/VehicleControlUnit/VehicleControlUnit.ioc

Mcu.UserName=STM32G473VETx
PA0.Signal=GPIO_Output
PA1.Signal=GPIO_Output
PA11.Signal=USB_DM
PA12.Signal=USB_DP
PA2.Signal=GPIO_Output
PA4.Signal=GPIO_Output
PA5.Signal=SPI1_SCK
PB12.Signal=FDCAN2_RX
PB13.Signal=FDCAN2_TX
PB14.Signal=SPI2_MISO
PB15.Signal=SPI2_MOSI
PB3.Signal=GPIO_Input
PB4.Signal=SPI1_MISO
PB5.Signal=SPI1_MOSI
PC0.Signal=ADC2_IN6
PC1.Signal=ADC2_IN7
PC10.Signal=SPI3_SCK
PC11.Signal=SPI3_MISO
PC12.Signal=SPI3_MOSI
PC13.Signal=GPIO_Output
PC14-OSC32_IN.Signal=GPIO_Output
PC15-OSC32_OUT.Signal=GPIO_Output
PC4.Signal=ADC2_IN5
PC6.Signal=I2C4_SCL
PC7.Signal=I2C4_SDA
PC8.Signal=GPIO_Input
PC9.Signal=GPIO_Output
PD0.Signal=FDCAN1_RX
PD1.Signal=FDCAN1_TX
PD4.Signal=GPIO_Output
PD5.Signal=GPIO_Output
PE0.Signal=GPIO_Output
PF0-OSC_IN.Signal=RCC_OSC_IN
PF1-OSC_OUT.Signal=RCC_OSC_OUT
PF9.Signal=SPI2_SCK
