lhr-solar/VehicleControlUnit/(commit log)

2026-09-07 mcu pinouts todo - peripherals done
    [100PinMCU.kicad_sch, 12VBuck.kicad_sch, 3V3Buck.kicad_sch, 5VBuck.kicad_sch, CAN_Transceiver.kicad_sch, CarCAN.kicad_sch, EMC2305-1-AP-TR.stp, ESP32.kicad_sch]
2026-09-08 VCU more like diddle-u, mika time
    [100PinMCU.kicad_sch, 12VBuck.kicad_sch, CarCAN.kicad_sch, LDO.kicad_sch, MUC_Peripherals.kicad_sch, Motor_Comms.kicad_sch, PowerProtection.kicad_sch, Power_Mux.kicad_sch]
2026-09-08 bleh booff zib zap
    [MUC_Peripherals.kicad_sch, Power_Regulation.kicad_sch]
2026-09-08 mika changes
    [12VBuck.kicad_sch, LDO.kicad_sch, MUC_Peripherals.kicad_sch, Motor_Comms.kicad_sch, Power_Mux.kicad_sch, USB-C Connector.kicad_sch, motor_fans.kicad_sch]
2026-09-08 need to add foot prints and start layout
    [Motor_Comms.kicad_sch]
2026-09-10 ughhhhhhhhhhhhhhhhhhh VCU will lokwey explode and propell the car
    [100PinMCU.kicad_sch, 12VBuck.kicad_sch, CarCAN.kicad_sch, MUC_Peripherals.kicad_sch, Motor_Comms.kicad_sch, PowerProtection.kicad_sch, Power_Mux.kicad_sch, Power_Regulation.kicad_sch]
2026-09-10 need to update design blocks
    [MUC_Peripherals.kicad_sch, Motor_Comms.kicad_sch, Power_Regulation.kicad_sch, motor_fans.kicad_sch]
2026-09-12 pre layout
    [100PinMCU.kicad_sch, 12VBuck.kicad_sch, CarCAN.kicad_sch, IRLML2030TRPBF.stp, LDO.kicad_sch, MUC_Peripherals.kicad_sch, Motor_Comms.kicad_sch, PowerProtection.kicad_sch]
2026-09-12 stoopid lck files
    [12VBuck.kicad_sch, Motor_Comms.kicad_sch, Power_Regulation.kicad_sch, RM-3.33.3S.step, ROE-3.305S.step, USB-C Connector.kicad_sch, motor_fans.kicad_sch]
